palmerRobotics/Linus-LineFollowingRobot/demos/linus_pic.jpg

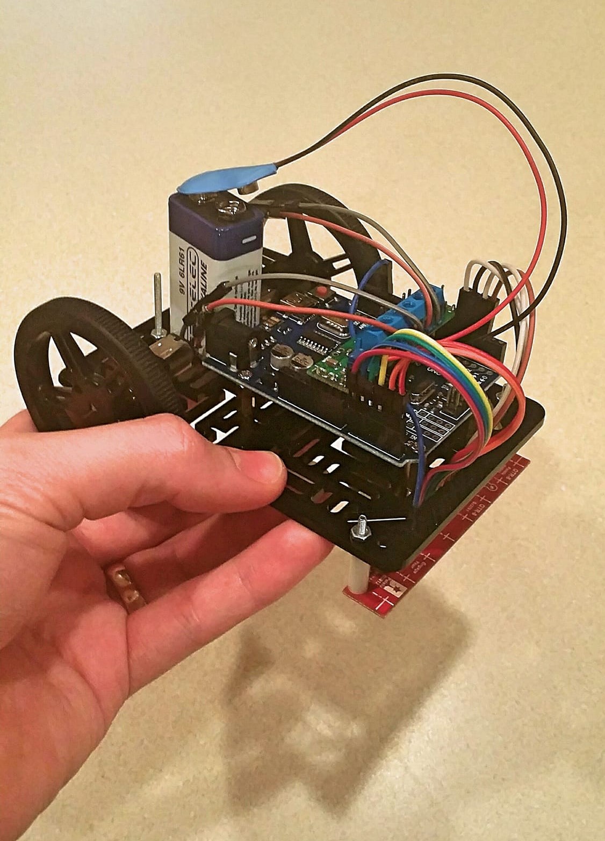
demos/linus_pic.jpg
