palmerRobotics/Linus-LineFollowingRobot/Bill of Materials.xlsx

Parts List
Part | Individual Cost | Quantity | Total Cost | Link
Dual MAX14870 Motor Driver Shield for Arduino | 6.95 | 1 | 6.95 | https://www.pololu.com/product/2511
Pololu Motor | 15.95 | 2 | 31.9 | https://www.pololu.com/product/2369
Gearmotor Bracket | 4.99 | 1 | 4.99 | https://www.pololu.com/product/989
QTR-8RC Reflectance Sensor Array | 9.95 | 1 | 9.95 | https://www.pololu.com/product/961
Chassis | 6.95 | 1 | 6.95 | https://www.pololu.com/product/1531
Ball Caster | 3.99 | 1 | 3.99 | https://www.pololu.com/product/954
Nylon spacers | 1.49 | 1 | 1.49 | https://www.pololu.com/product/1971
Male-Female Standoffs
Washers
Wheels | 7.95 | 1 | 7.95 | https://www.pololu.com/product/1420
 | Total Cost: |  | 66.22
 |  |  |  |  | https://www.pololu.com/file/0J1487/pololu-micro-metal-gearmotors.pdf
