palmerRobotics/Linus-LineFollowingRobot/Wiring Diagram.pdf

# 10 Dual MAX14870 Motor Driver Shield

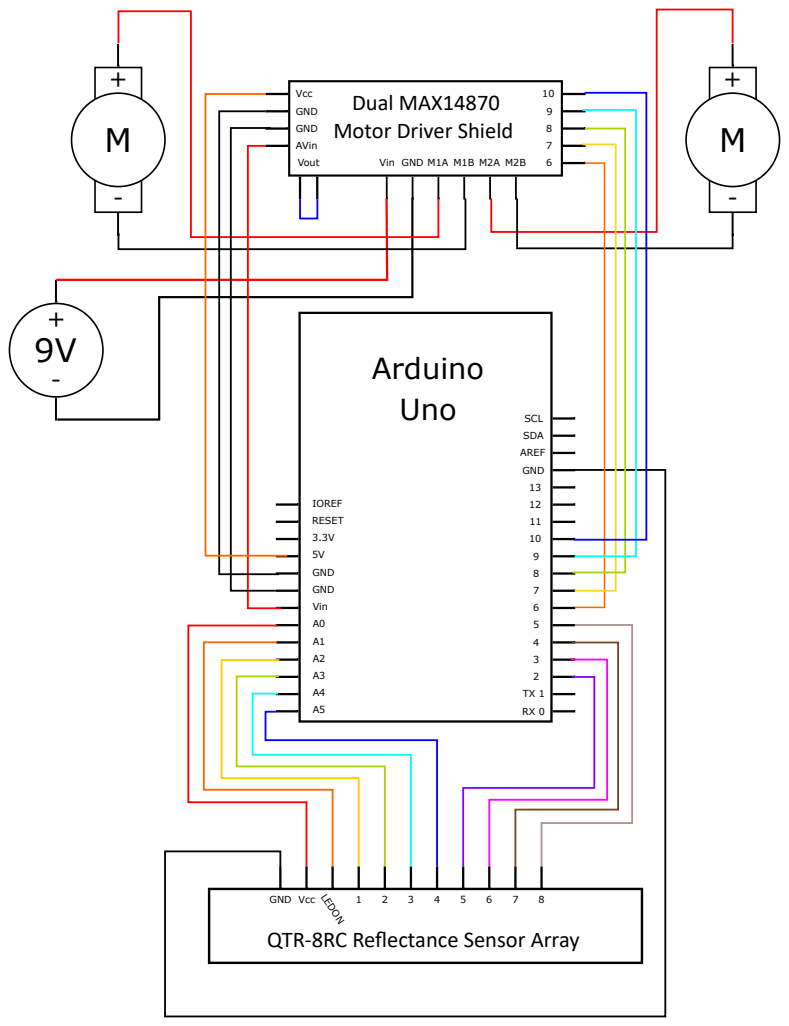
[picture p2: page 1]
Arduino Uno; GND; AREF; SDA; SCL; Vin; RESET; IOREF; AVin; Vcc; Vout; Vin GND M1A M1B M2A M2B

GND Vcc LEDON
QTR-8RC Reflectance Sensor Array
