palmerRobotics/Linus-LineFollowingRobot/Motor Driver Voltage Output Test Results.txt

This test measures the motor driver output voltage given function inputs ranging from 0 to 400 in increments of 50.  The function setSpeeds(M1spd, M2spd) accepts an input of -400 to 400, -400 being 100% PWM in reverse, 0 being 0% PWM, and 400 being 100% PWM in forward drive.  The motor driver and Arduino were powered separately in this test. (so that data could be output to my monitor)

Function	Motor Driver 
Input		Output Voltage
0:		0V
50:		1.14V
100:		2.27V
150:		3.4V
200:		4.54V
250:		5.67V
300:		6.8V
350:		7.93V
400:		9.05V

These results show that 100% PWM with a 9V power supply far exceeds the rated motor voltage of 6V.  Continued exposure to such a high voltage will damage the motor.  These results also indicate that the motor driver output voltage can match the power supply voltage *if the Arduino and motor driver are powered separately (the condition was discoved later).  This was not indicated anywhere on the motor driver datasheet but is very useful information.  

The results show that a 6V motor driver output voltage occurs somewhere between function input values of 250 and 300.  The next test will narrow down the input range and will use smaller increments.  

Function	Motor Driver 
Input		Output Voltage
250:		5.67V
260:		5.89V
270:		6.12V
280:		6.35V
290:		6.58V
300:		6.8V

Narrowing down the range to 260-270, in increments of two...

Function	Motor Driver 
Input		Output Voltage
260:		5.89V
262:		5.94V
264:		5.98V
266:		6.03V
268:		6.07V
270:		6.12V

These results show that a value of 264 will achieve the desired 6V output voltage.  It would be wise to set the maximum lower than 264 to play it safe.  

IMPORTANT NOTE: With the motor driver powering the arduino, the motor driver output voltage was measured at 5.55V when using a function input of 264.  This makes sense, as the motor driver and arduino were powered separately in previous tests.  But it now provides a problem: I am currently unable to test the motor driver output while it powers the arduino, as I have no easy way of knowing the function input in this configuration.  I cannot power the arduino from both my computer and the motor driver at the same time, or I will blow up both of them.  A separate screen is necessary, and I do not have one.
