palmerRobotics/Linus-LineFollowingRobot/(commit log)

2019-04-07 added existing design files, test procedures, and test results of line following robot.
    [Bill of Materials.xlsx]
2019-04-07 added existing arduino code. Includes code for test procedures as well as final code for successful line following.
